Fagear/Beta10Pin/osc/rec_pulse.png

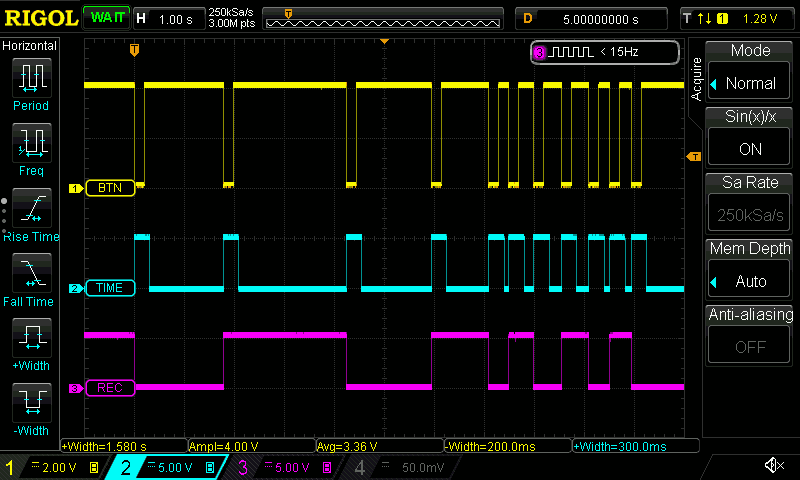
osc/rec_pulse.png
