Fagear/Beta10Pin/osc/rec_toggle.png

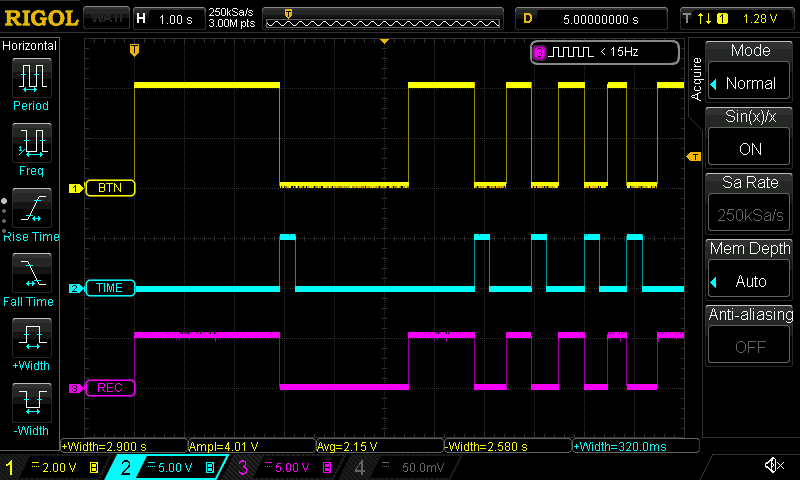
osc/rec_toggle.png
