Fagear/Beta10Pin/osc/serial_link.png

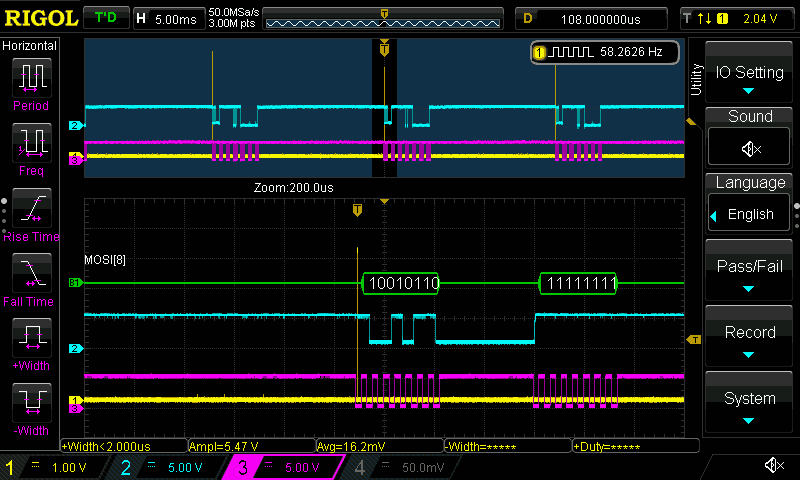
osc/serial_link.png
