Fagear/Beta10Pin/osc/serial_no_link.png

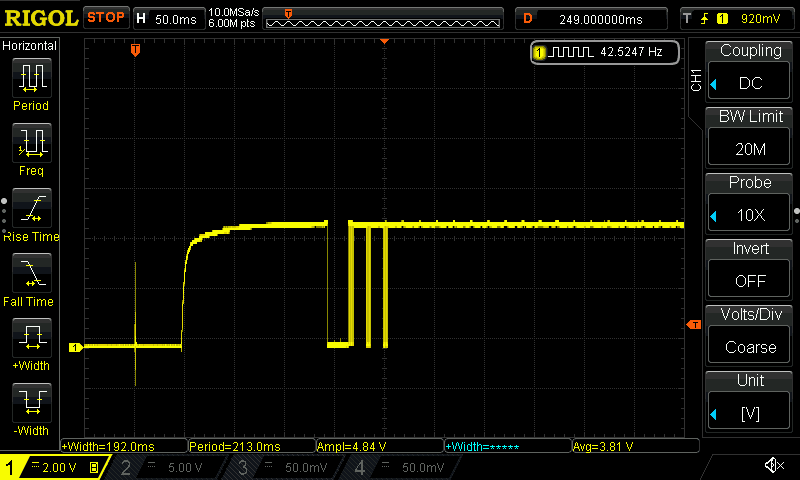
osc/serial_no_link.png
