Fagear/Beta10Pin/progress/adapter_open.jpg

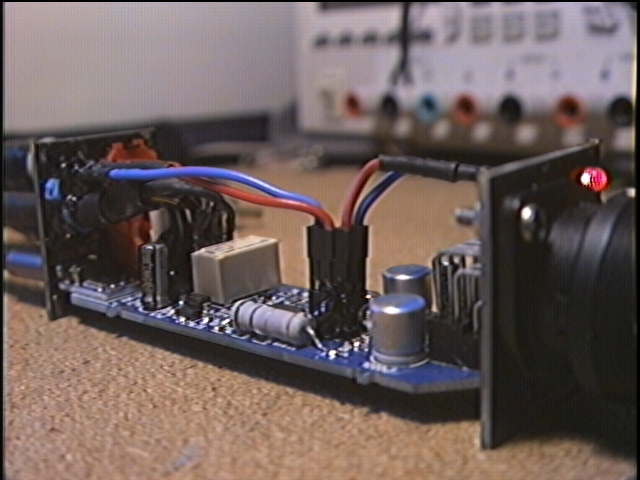
progress/adapter_open.jpg
