Fagear/Beta10Pin/progress/wrong_opamp.jpg

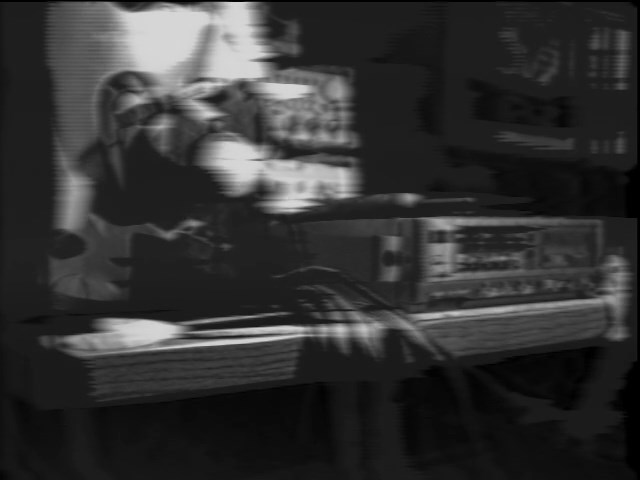
progress/wrong_opamp.jpg
