Fagear/Beta10Pin/(list of files, drawings)

Other design files:
14P-10P.lay6
