Fagear/Beta10Pin/(commit log)

2024-04-25 Working logic, serial link draft
    Added proper inputs sampling and outputs applying, added auto-detection for level or triggered REC button, added ADC measurements for voltages IN and OUT, added "low battery" and "no camera" flags, added logic processing, added delays (startup, PB/REC switch), added working serial link driver (link detection, two-directional data transmittion), fast blinking changed to 5 Hz, added 4 debug outputs.
2024-04-30 Working power measurement, HAL update, fixes
    Updated hardware defines for production PCB, updated ADC read to 10-bit LUT-converted to 8-bit, added detection of power save or offline camera, small improvements for serial link driver, added definitions for serial protocol, added dedicated state variable.
    [config.h, drv_io.h, sony10p.c, sony10p.h]
2024-04-30 Helper binaries
    Added PCB project and Excel helper files
    [14P-10P.lay6, adc2byte.xlsm, calcs.xlsx]
2024-05-03 Working draft serial control
    Updated ADC LUT, fixed serial link dropout when VTR put in record mode (added tally signal identification in progress), split state machine operation into serial linked/standalone modes, working draft state machine for linked mode, updated blinking flags
    [adc2byte.xlsm]
2024-05-04 Working serial control, error indication
    Finished serial mode state machine, updated input parser to support all three record button modes, added delay for camera fader, added compile-time options for features, slower low battery blink, small code clean-ups.
    [config.h, drv_io.h, sony10p.c, sony10p.h]
2024-05-05 Fixed ADC readings quality
    Re-configured ADC to use internal Vref, added filtering for ADC data, added hysteresis for ADC thresholds
    [adc2byte.xlsm, calcs.xlsx]
2024-05-05 Fixed ADC filtering, fixed control fallback
    Optimized ADC filtering, fixed system timing skewing, added watchdog to serial link and graceful fallback from serial to wired control.
    [sony10p.c, sony10p.h]
2024-05-06 PCB updated, code updated to match
    Opamp was integrated to buffer video path
    [14P-10P.lay6]
2024-05-14 Working Record Review function
    Added "RR" button processing (new states, new timers, new logic), debug pins "production" re-assignment, optimizations to fit FW in ATmega48, small README updates
2024-05-15 Almost final logic
    Added debug error code blinking, added compile-time flag for ATmega48 (to fit FW into 4K), small logic fixes, code cleanup and optimization, more documentation (in comments)
    [config.h, drv_io.h, sony10p.c, sony10p.h]
2024-05-15 Pre-release fixes
    Updated README, small code optimizations and fixes, debug output rewiring for production PCB
    [config.h, drv_cpu.h, drv_io.h, sony10p.c, sony10p.h]
2024-05-15 First release (FW + PCB)
    Record mode drop out fixed, project prepared for release.
    [14P-10P.lay6]
2024-07-03 Camera power measurement fix
    Fixed failed ADC/wrong shunt value causing logic looping and ignoring camera
    [drv_io.h, sony10p.c, sony10p.h]
2024-07-03 LED connection fix
    Updated LED connector pinout to match hardware
    [drv_io.h, sony10p.c]
2024-07-24 Fixed hardware after rev. 01, small code updates
    Battery charge level is now taken from serial link data if it is present, updated PCB (ADC connection fix, current shunt footprint fix, more heat spreading, more robust 'pause' output), updated README (clarifications, added usage for direct mode), added some oscilloscope and capture screenshots
    [14P-10P.lay6]
2024-07-27 More RR features, batt from VTR
    Added playback review reverse with record button, added battery charge level pickup from serial transmission from VTR, updated voltage LUT for input supply measurement, updated camera power calculation to prevent false "camera off" flags on low battery, dropped ATmega48 support, updated README, some code refactoring
    [adc2byte.xlsm, calcs.xlsx]
2024-07-27 Updated PCBs
    Small updates for PCBs
    [14P-10P.lay6]
2024-08-17 Power saving update
    VTR now will be removed from power saving mode when camera is turned back on (to allow VTR prepare for recording before it starts)
2024-12-10 Bug fixes, updated to v1.4
    Fixed (inverted) rec pause output in FW, fix for camera detection on higher (>14 V) input voltages, made blinking speeds more distinctive, fixed LED connection markings for PCB, updated README
    [14P-10P.lay6]
